soligen2010/ElectronicLoad/MainSchematic.png

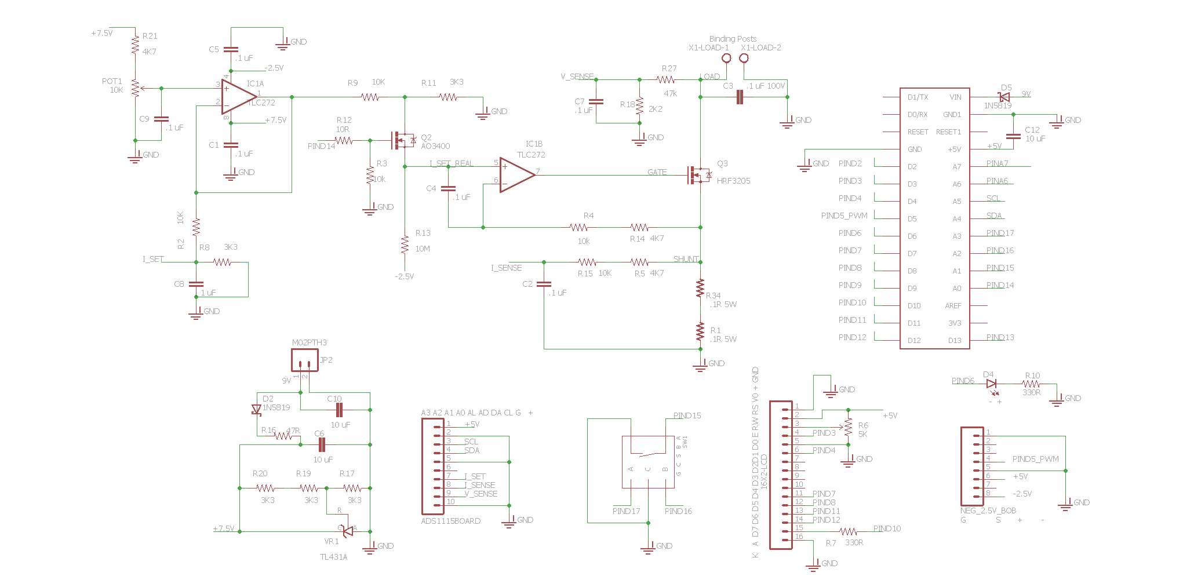
MainSchematic.png
