soligen2010/ElectronicLoad/Neg25BobSchematic.png

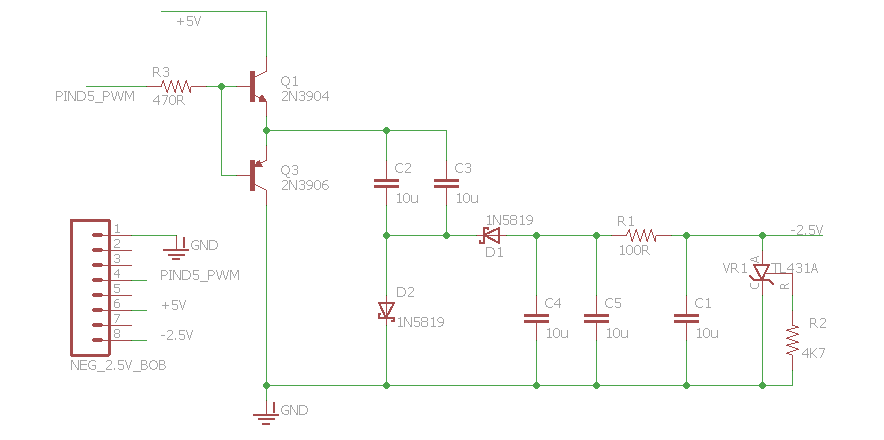
Neg25BobSchematic.png
