soligen2010/ElectronicLoad/Eagle Files/Main-Top.pdf

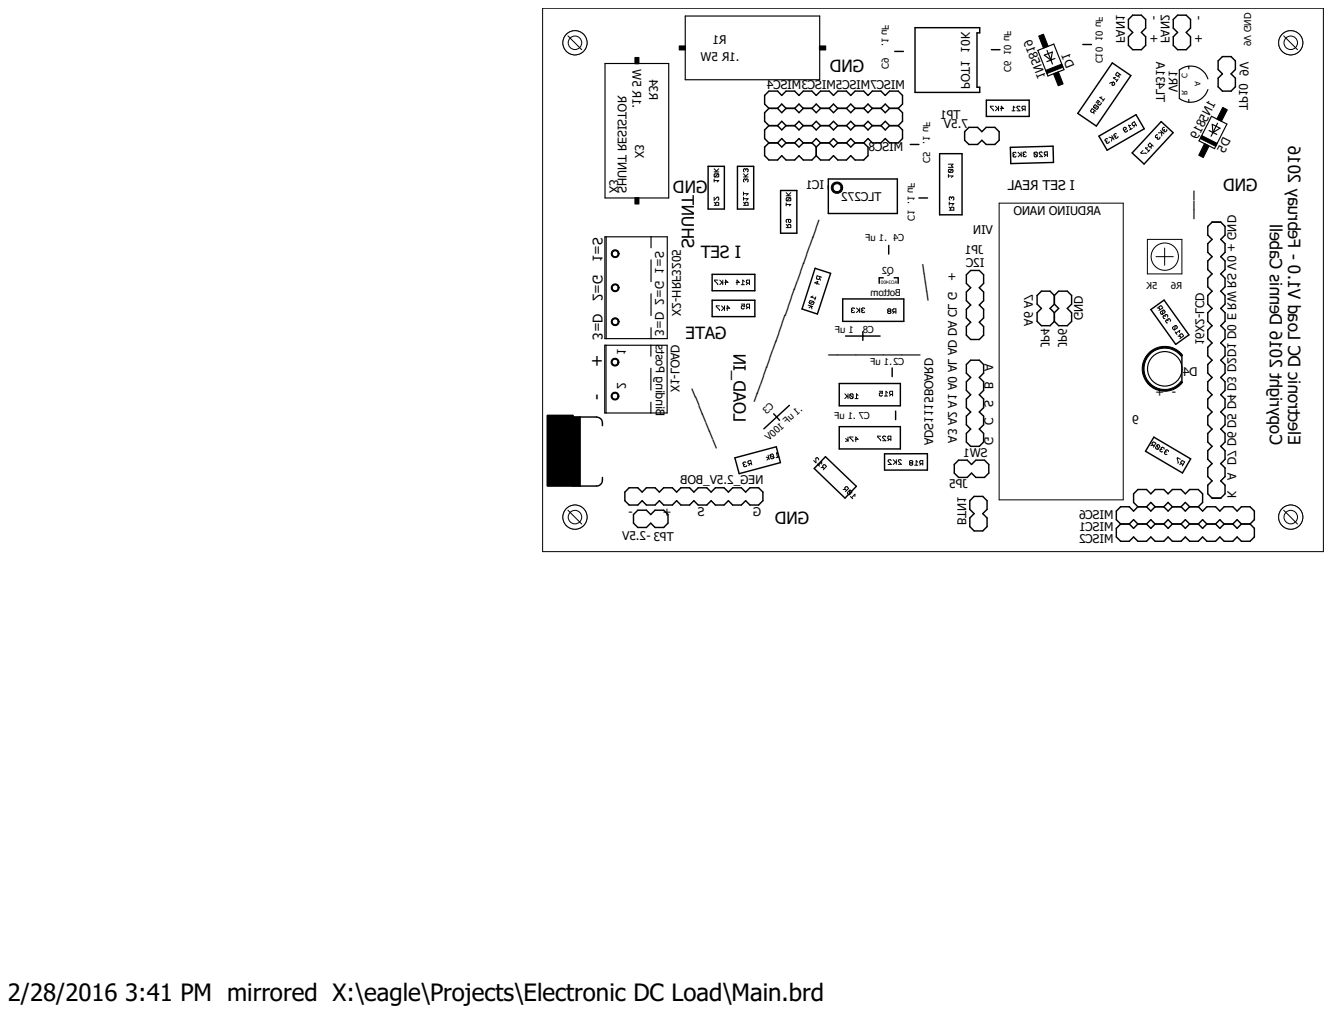
[picture p3: page 1]

Electronic DC Load V1.0 - Februay 2016 Copyright 2016 Dennis Cabell K A D7 D6 D5 D4 D3 D2D1 D0 E RW RS V0 + GND

2/28/2016 3:41 PM mirrored X:\eagle\Projects\Electronic DC Load\Main.brd
