soligen2010/ElectronicLoad/Eagle Files/Main.pdf

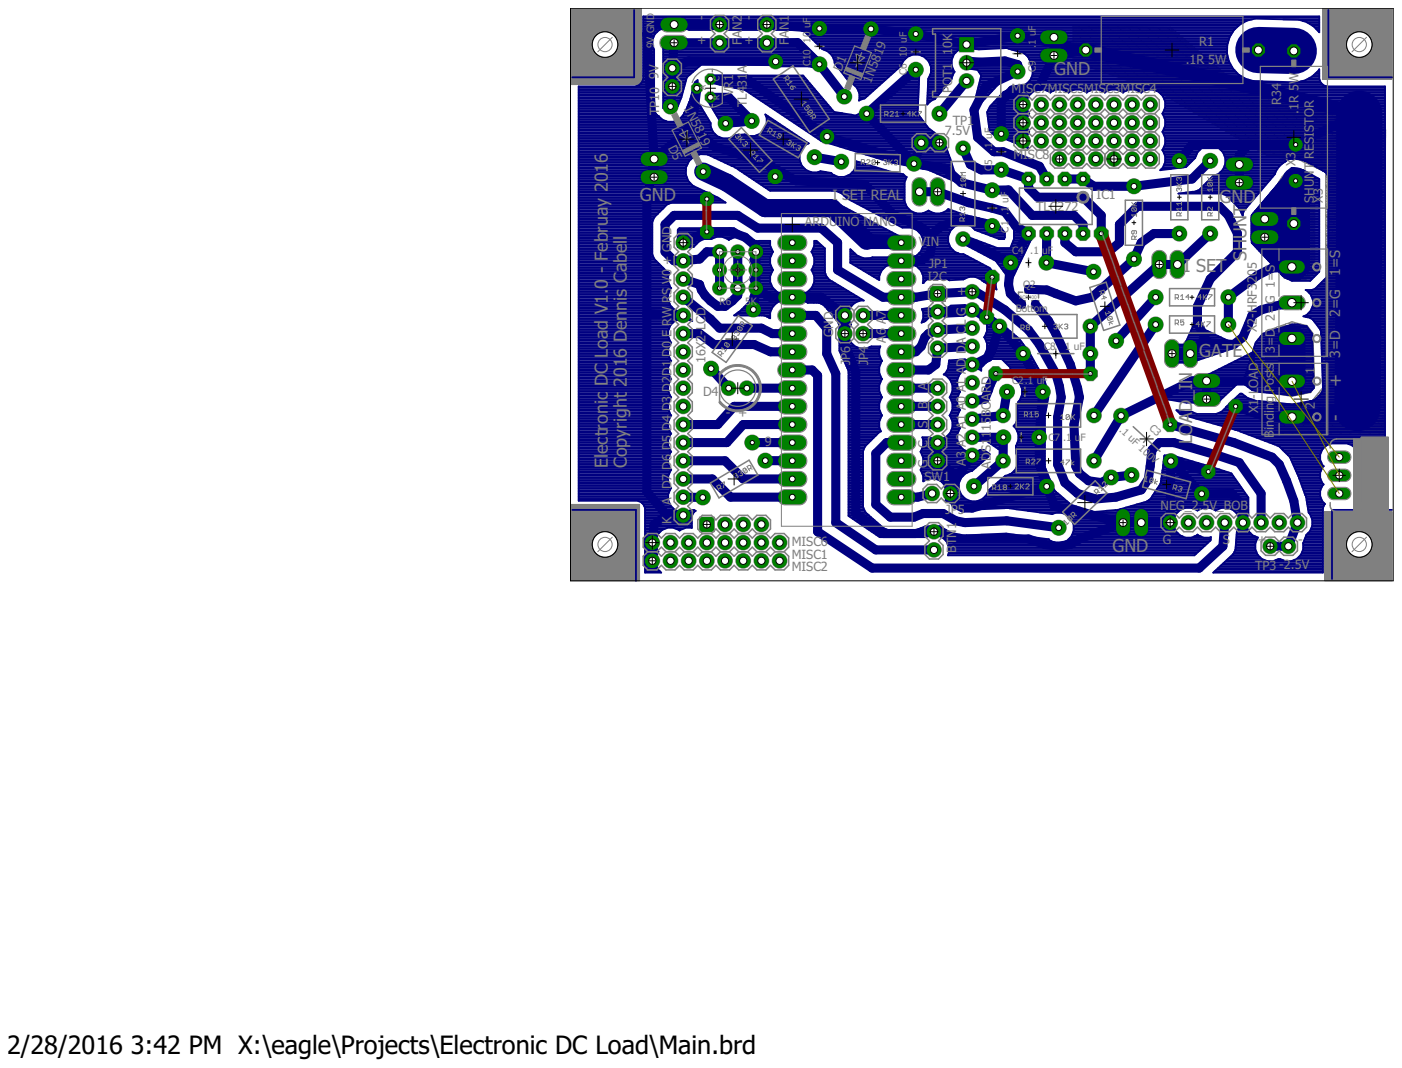
[picture p4: page 1]
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

Bottom __________

2/28/2016 3:42 PM X:\eagle\Projects\Electronic DC Load\Main.brd
