soligen2010/ElectronicLoad/Eagle Files/Main-Bot.pdf

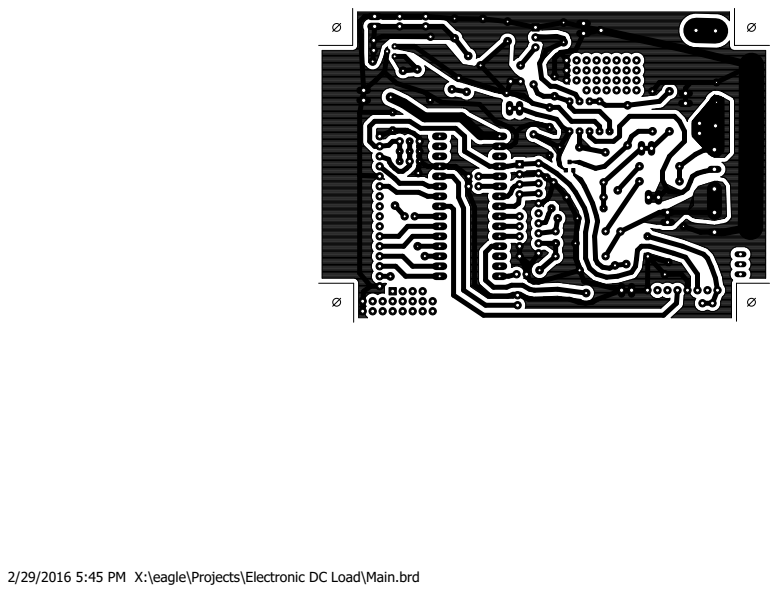
[picture p5: page 1]

2/29/2016 5:45 PM X:\eagle\Projects\Electronic DC Load\Main.brd
