soligen2010/ElectronicLoad/Eagle Files/Main-BotPads.pdf

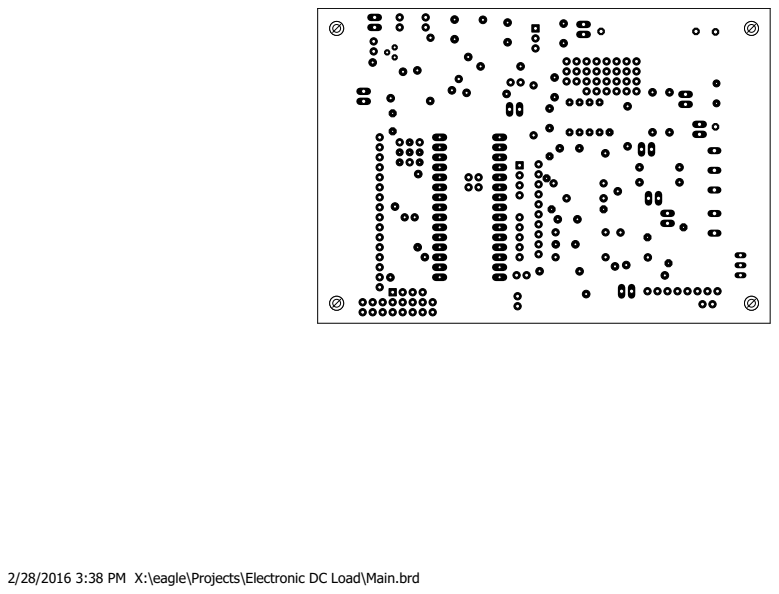
[picture p6: page 1]

2/28/2016 3:38 PM X:\eagle\Projects\Electronic DC Load\Main.brd
