soligen2010/ElectronicLoad/Eagle Files/Main.brd

## EAGLE design Eagle Files/Main.brd (2018-12-31)

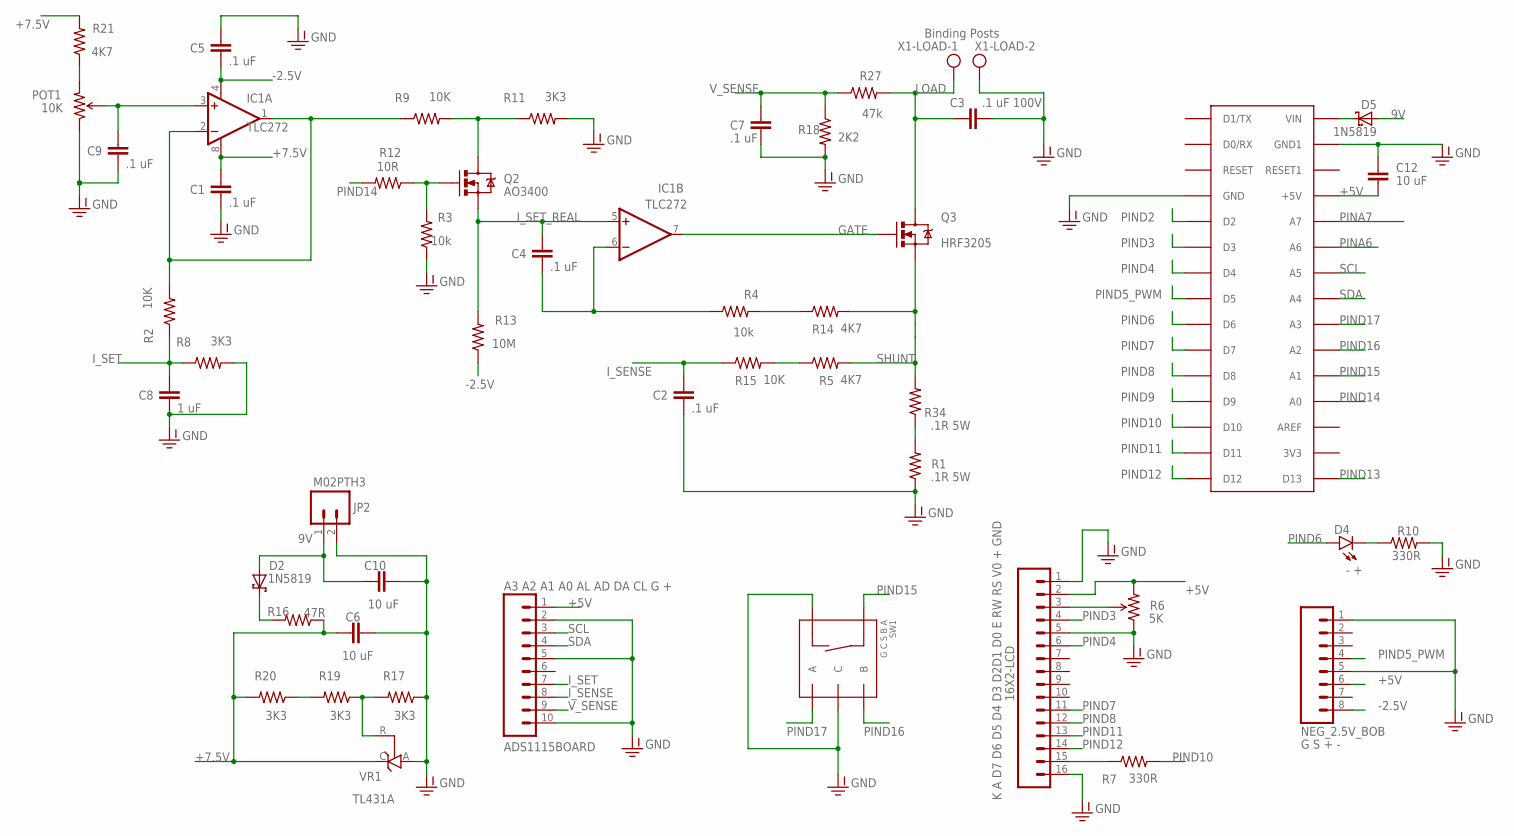
[picture p7: schematic Main.sch, sheet 1]

Parts:
16X2-LCD: K A D7 D6 D5 D4 D3 D2D1 D0 E RW RS V0 + GND; 1X16
ADS1115BOARD: A3 A2 A1 A0 AL AD DA CL G +; 1X10_NO_SILK
ARDUINO_NANO: NANO; PDIP-32
C1, C2, C4, C5, C7, C9: .1 uF; CAP-PTH-5MM
C3: .1 uF 100V; CAP-PTH-5MM
C6, C10, C12: 10 uF; CAP-PTH-5MM
C8: 1 uF; CAP-PTH-5MM
D2, D5: 1N5819; DO41-10
D4: - +; LED5MM
IC1: TLC272; DIP08
JP2: M02PTH3; 1X02_LONGPADS
NEG_2.5V_BOB: G S + -; 1X08_ROUND
POT1: 10K; 3386U
Q2: AO3400; SOT23-3
Q3: HRF3205; TO220V
R1, R34: .1R 5W; VTA53
R2, R9: 10K; AXIAL-0.4
R3, R4: 10k; AXIAL-0.4
R5, R14, R21: 4K7; AXIAL-0.4
R6: 5K; TRIM_POT_PTH
R7, R10: 330R; AXIAL-0.4
R8: 3K3; AXIAL-0.5
R11, R17, R19, R20: 3K3; AXIAL-0.4
R12: 10R; AXIAL-0.4
R13: 10M; AXIAL-0.5
R15: 10K; AXIAL-0.5
R16: 47R; AXIAL-0.4
R18: 2K2; AXIAL-0.4
R27: 47k; AXIAL-0.5
SW1: G C S B A; 1X05
VR1: TL431A; TO92-CLP
X1-LOAD: Binding Posts; W237-102

Connections:
9V: C10.1, D2.A, D5.A, JP2.1; also elsewhere on the board
+5V: 16X2-LCD.2, ADS1115BOARD.1, ARDUINO_NANO.+5V, C12.1, NEG_2.5V_BOB.6, R6.3 (CW); also elsewhere on the board
+7.5V: C1.1, C6.1, IC1.8 (V+), R16.P$1 (1), R20.P$2 (2), R21.P$2 (2), VR1.C; also elsewhere on the board
-2.5V: C5.2, IC1.4 (V-), NEG_2.5V_BOB.8, R13.P$1 (1); also elsewhere on the board
GATE: IC1.7 (OUT), Q3.1 (G); also elsewhere on the board
GND-ISO: 16X2-LCD.1, 16X2-LCD.5, 16X2-LCD.16, ADS1115BOARD.2, ADS1115BOARD.5, ADS1115BOARD.10, ARDUINO_NANO.GND, ARDUINO_NANO.GND1, C1.2, C2.2, C3.2, C5.1, C6.2, C7.2, C8.2, C9.2, C10.2, C12.2, JP2.2, NEG_2.5V_BOB.1, NEG_2.5V_BOB.5, POT1.1 (CCW), R1.1, R3.P$1 (1), R6.1 (CCW), R8.P$2 (2), R10.P$2 (2), R11.P$2 (2), R17.P$1 (1), R18.P$2 (2), SW1.1 (SW-), SW1.2 (C), VR1.A, X1-LOAD.2; also elsewhere on the board
I_SENSE: ADS1115BOARD.8, C2.1, R15.P$1 (1)
I_SET: ADS1115BOARD.7, C8.1, R2.P$1 (1), R8.P$1 (1); also elsewhere on the board
I_SET_REAL: C4.1, IC1.5 (+IN), Q2.2 (S), R13.P$2 (2); also elsewhere on the board
LOAD: C3.1, Q3.2 (D), R27.P$2 (2), X1-LOAD.1; also elsewhere on the board
unnamed: R1.2, R34.1
unnamed: 16X2-LCD.15, R7.P$1 (1)
unnamed: R4.P$2 (2), R14.P$1 (1)
unnamed: 16X2-LCD.3, R6.2 (WIPER)
unnamed: C9.1, IC1.3 (+IN), POT1.2 (WIPER)
unnamed: D2.C, R16.P$2 (2)
unnamed: IC1.1 (OUT), IC1.2 (-IN), R2.P$2 (2), R9.P$1 (1)
unnamed: ARDUINO_NANO.VIN, D5.C
unnamed: Q2.3 (D), R9.P$2 (2), R11.P$1 (1)
unnamed: R5.P$1 (1), R15.P$2 (2)
unnamed: Q2.1 (G), R3.P$2 (2), R12.P$1 (1)
unnamed: D4.K (C), R10.P$1 (1)
unnamed: POT1.3 (CW), R21.P$1 (1)
unnamed: R17.P$2 (2), R19.P$1 (1), VR1.R
unnamed: R19.P$2 (2), R20.P$1 (1)
unnamed: C4.2, IC1.6 (-IN), R4.P$1 (1)
PINA6: ARDUINO_NANO.A1 (A6); also elsewhere on the board
PINA7: ARDUINO_NANO.A0 (A7); also elsewhere on the board
PIND2: ARDUINO_NANO.D2; also elsewhere on the board
PIND3: 16X2-LCD.4, ARDUINO_NANO.D3
PIND4: 16X2-LCD.6, ARDUINO_NANO.D4
PIND5_PWM: ARDUINO_NANO.D5, NEG_2.5V_BOB.4
PIND6: ARDUINO_NANO.D6, D4.A
PIND7: 16X2-LCD.11, ARDUINO_NANO.D7
PIND8: 16X2-LCD.12, ARDUINO_NANO.D8
PIND9: ARDUINO_NANO.D9; also elsewhere on the board
PIND10: ARDUINO_NANO.D10, R7.P$2 (2)
PIND11: 16X2-LCD.13, ARDUINO_NANO.D11
PIND12: 16X2-LCD.14, ARDUINO_NANO.D12
PIND13: ARDUINO_NANO.D13; also elsewhere on the board
PIND14: ARDUINO_NANO.A7 (A0), R12.P$2 (2)
PIND15: ARDUINO_NANO.A6 (A1), SW1.3 (SW+)
PIND16: ARDUINO_NANO.A5 (A2), SW1.4 (B)
PIND17: ARDUINO_NANO.A4 (A3), SW1.5 (A)
SCL: ADS1115BOARD.3, ARDUINO_NANO.A2 (A5); also elsewhere on the board
SDA: ADS1115BOARD.4, ARDUINO_NANO.A3 (A4); also elsewhere on the board
SHUNT: Q3.3 (S), R5.P$2 (2), R14.P$2 (2), R34.2; also elsewhere on the board
V_SENSE: ADS1115BOARD.9, C7.1, R18.P$1 (1), R27.P$1 (1)

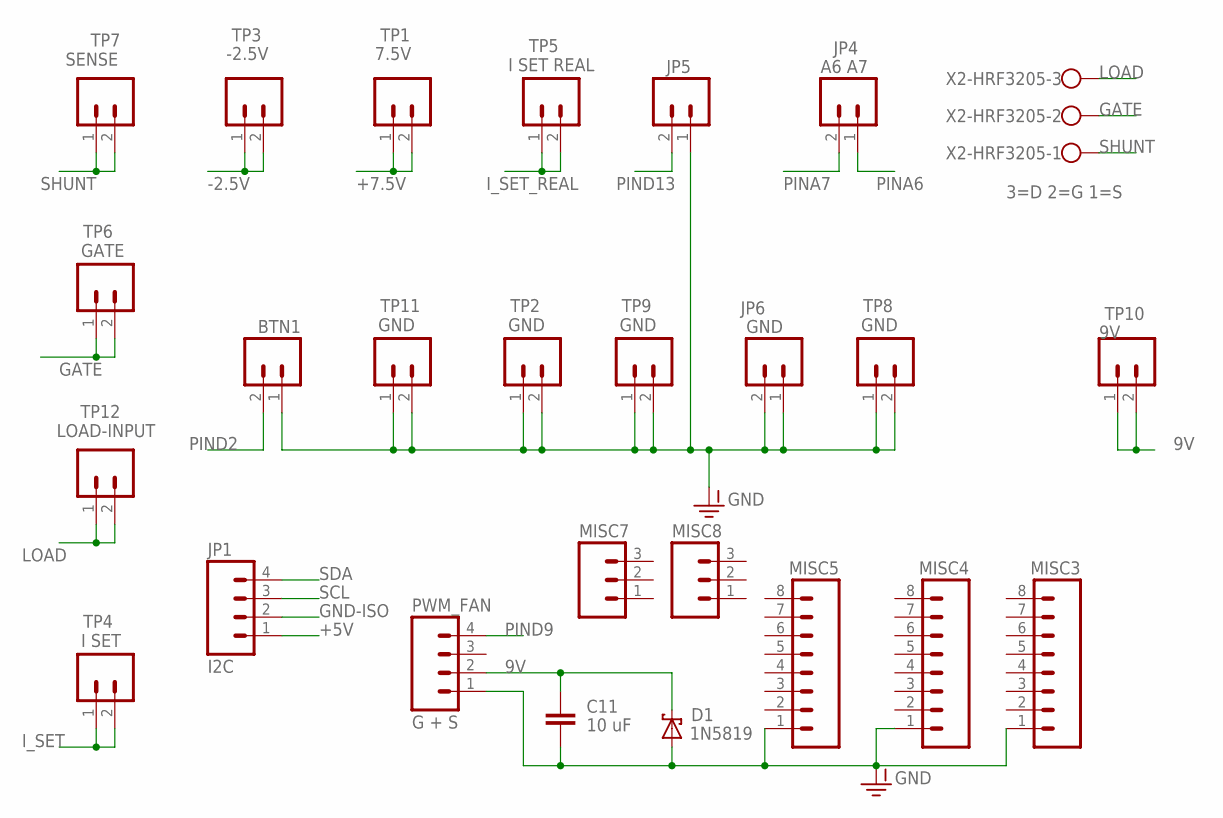
[picture p8: schematic Main.sch, sheet 2]

Parts:
BTN1: 1X02
C11: 10 uF; CAP-PTH-5MM
D1: 1N5819; DO41-10
JP1: I2C; 1X04
JP4: A6 A7; 1X02
JP5: 1X02
JP6: GND; 1X02
MISC3, MISC4, MISC5: 1X08_ROUND
MISC7, MISC8: 1X03
PWM_FAN: G + S; 1X04
TP1: 7.5V; 1X02
TP2, TP8, TP9, TP11: GND; 1X02_LONGPADS
TP3: -2.5V; 1X02
TP4: I SET; 1X02_LONGPADS
TP5: I SET REAL; 1X02_LONGPADS
TP6: GATE; 1X02_LONGPADS
TP7: SENSE; 1X02_LONGPADS
TP10: 9V; 1X02
TP12: LOAD-INPUT; 1X02_LONGPADS
X2-HRF3205: 3=D 2=G 1=S; W237-103

Connections:
9V: C11.2, D1.C, PWM_FAN.2, TP10.1, TP10.2; also elsewhere on the board
+5V: JP1.1; also elsewhere on the board
+7.5V: TP1.1, TP1.2; also elsewhere on the board
-2.5V: TP3.1, TP3.2; also elsewhere on the board
GATE: TP6.1, TP6.2, X2-HRF3205.2; also elsewhere on the board
GND-ISO: BTN1.1, C11.1, D1.A, JP1.2, JP5.1, JP6.1, JP6.2, MISC3.1, MISC4.1, MISC5.1, PWM_FAN.1, TP2.1, TP2.2, TP8.1, TP8.2, TP9.1, TP9.2, TP11.1, TP11.2; also elsewhere on the board
I_SET: TP4.1, TP4.2; also elsewhere on the board
I_SET_REAL: TP5.1, TP5.2; also elsewhere on the board
LOAD: TP12.1, TP12.2, X2-HRF3205.3; also elsewhere on the board
PINA6: JP4.1; also elsewhere on the board
PINA7: JP4.2; also elsewhere on the board
PIND2: BTN1.2; also elsewhere on the board
PIND9: PWM_FAN.4; also elsewhere on the board
PIND13: JP5.2; also elsewhere on the board
SCL: JP1.3; also elsewhere on the board
SDA: JP1.4; also elsewhere on the board
SHUNT: TP7.1, TP7.2, X2-HRF3205.1; also elsewhere on the board

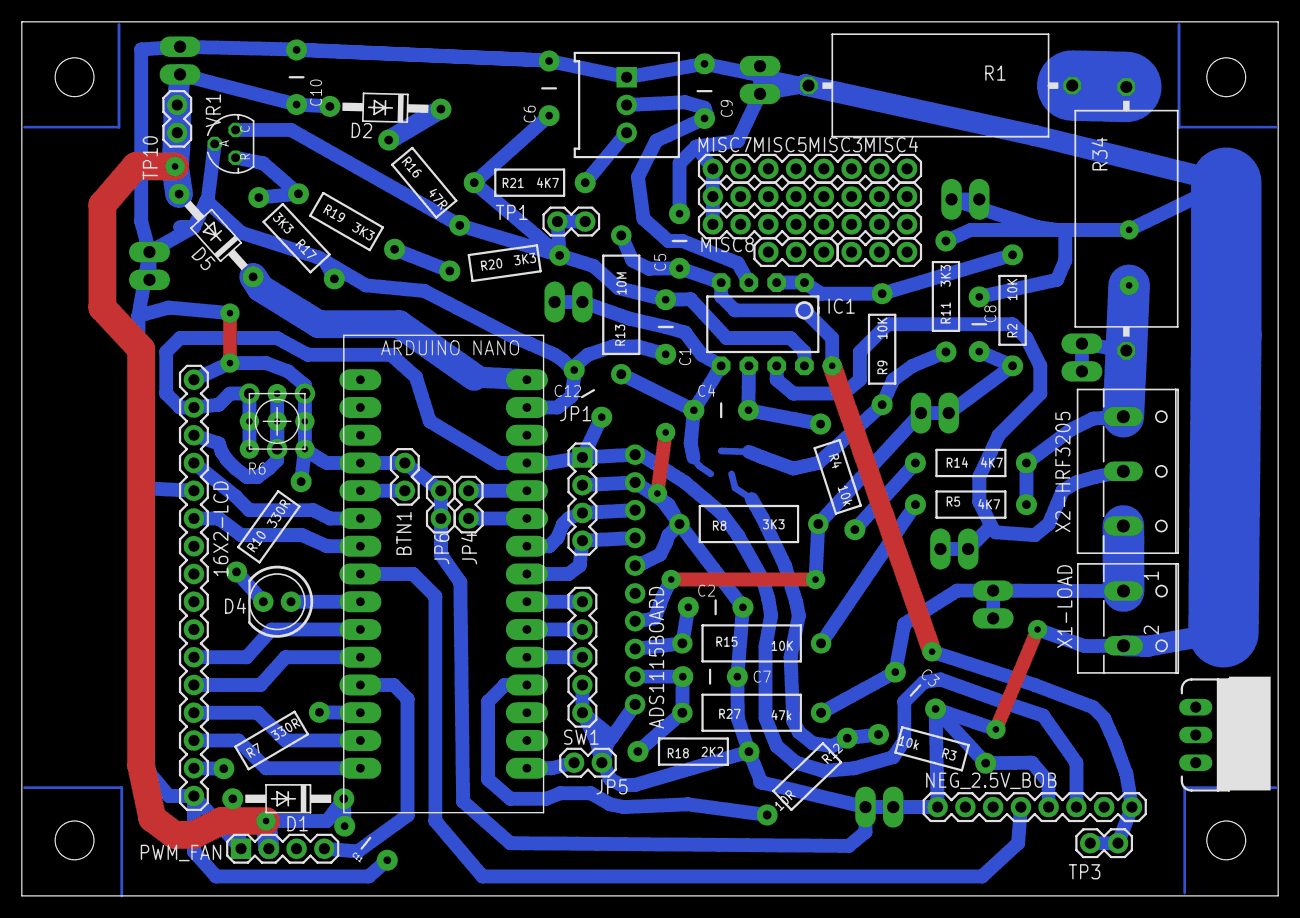
[picture p9: board Main.brd from above]

Board: 2 copper layers, 115.0 x 80.0 mm, 75 parts (1 on the bottom side), 48 nets.
